halherta/GPIO_ADC_uHAT/production/bom.xls

Comment | Designator | Footprint | JLCPCB Part #
10k | R1,R5,R6 | 1206 | C17902
1k | R2 | 1206 | C1469
Conn_01x02 | J5 | PinHeader_1x02_P2.54mm_Vertical | C492401
CAT24C128 | U3 | SOIC-8_3.9x4.9mm_P1.27mm | C81195
3.9k | R3,R4 | 1206 | C17883
Conn_01x10 | J2,J3 | PinHeader_1x10_P2.54mm_Vertical | C5116489
Conn_01x08 | J4 | PinHeader_1x08_P2.54mm_Vertical | C5224027
MCP3208 | U4 | SOIC-16_3.9x9.9mm_P1.27mm | C16939
MCP23017_SO | U1 | SOIC-28W_7.5x17.9mm_P1.27mm | C47023
0.1u | C1,C2,C3 | 1206 | C1945
