halherta/GPIO_ADC_uHAT/schematic/GPIO_ADC_uHAT_schematic.pdf

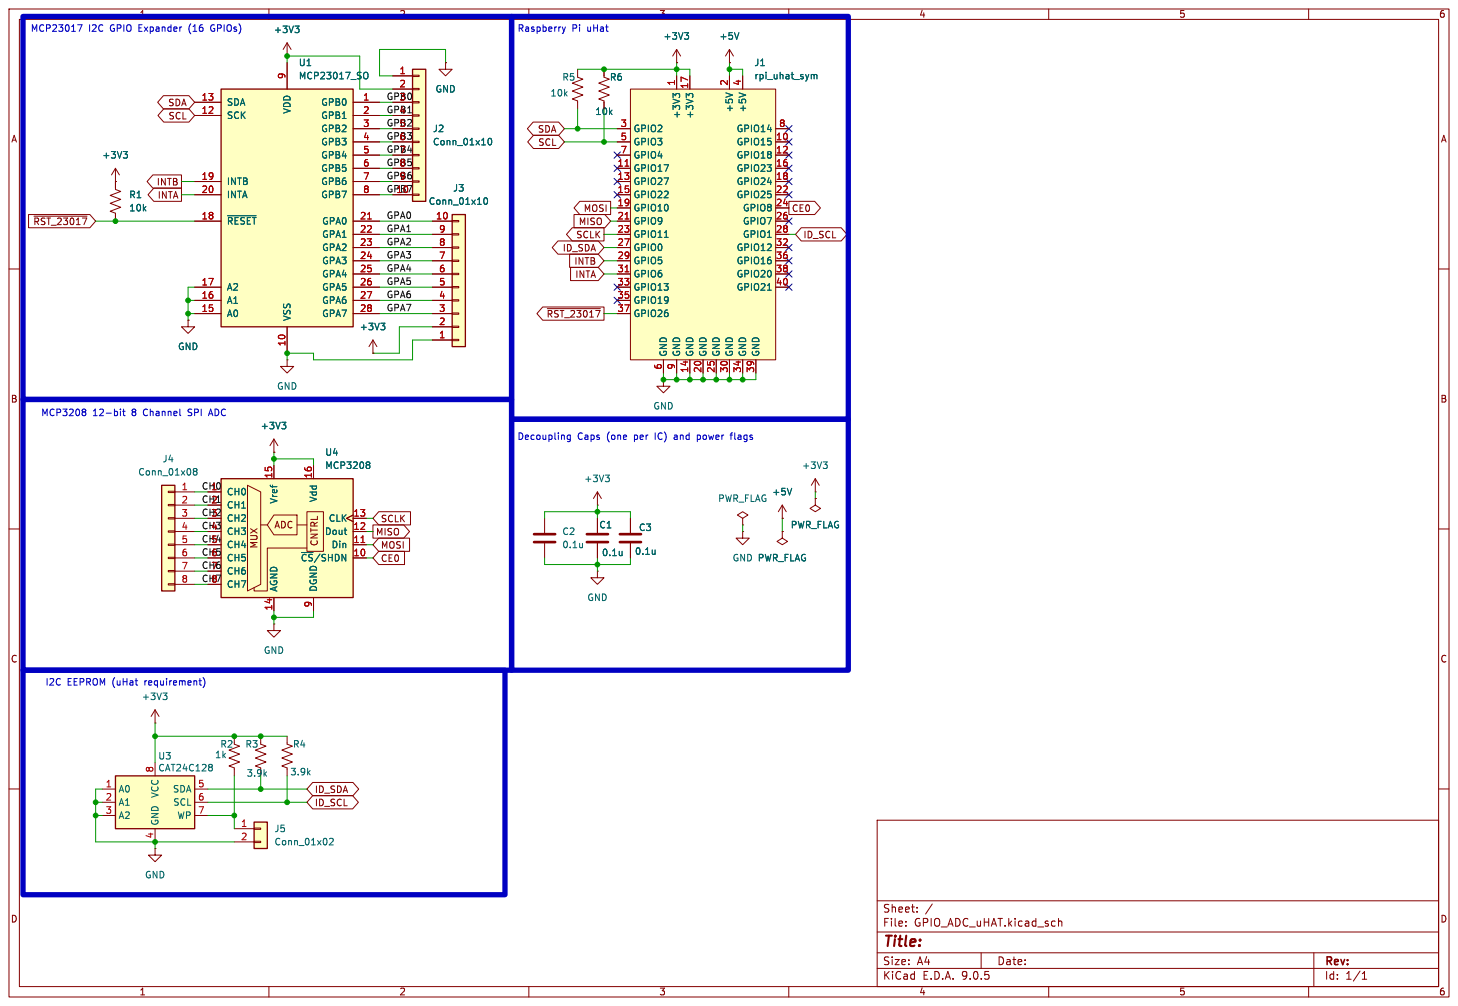
[picture p1: page 1]

Id: 1/1 Title: File: GPIO_ADC_uHAT.kicad_sch Sheet: /
