halherta/GPIO_ADC_uHAT/GPIO_ADC_uHAT.kicad_pcb

## KiCad design GPIO_ADC_uHAT.kicad_pcb (2025-11-06)

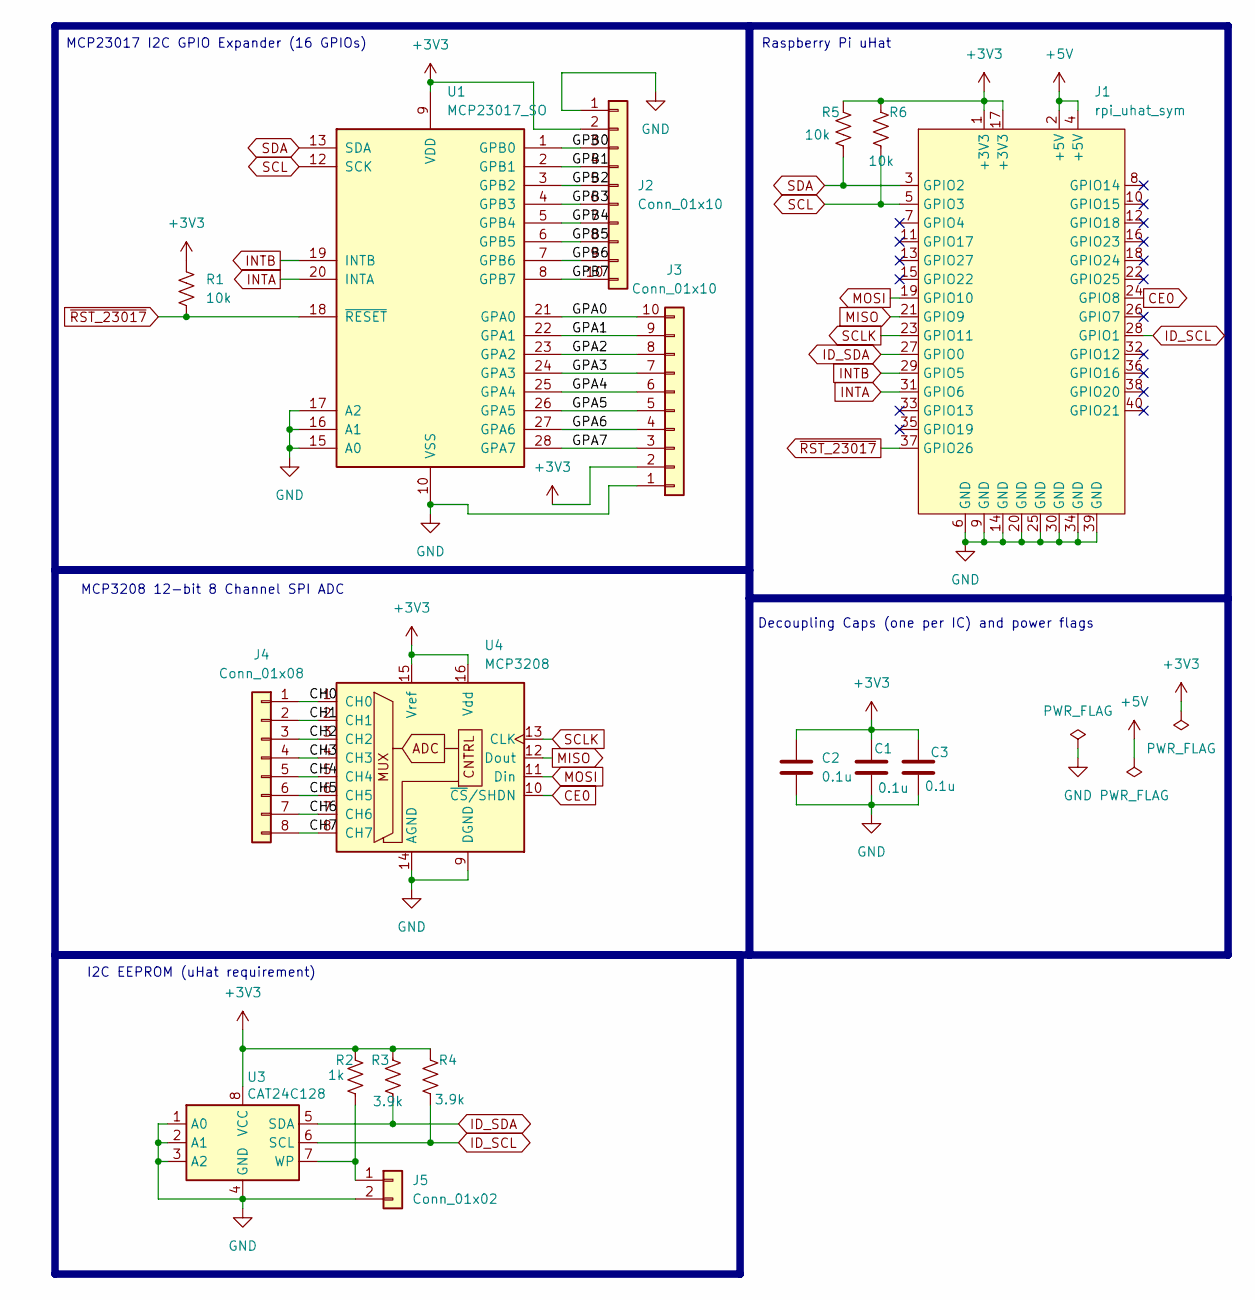
[picture p2: schematic GPIO_ADC_uHAT.kicad_sch]

Parts:
C1, C2, C3: 0.1u; C_1206_3216Metric_Pad1.33x1.80mm_HandSolder
J1: rpi_uhat_sym; rpi_uhat_fpt_v2
J2, J3: Conn_01x10; PinHeader_1x10_P2.54mm_Vertical
J4: Conn_01x08; PinHeader_1x08_P2.54mm_Vertical
J5: Conn_01x02; PinHeader_1x02_P2.54mm_Vertical
R1, R5, R6: 10k; R_1206_3216Metric_Pad1.30x1.75mm_HandSolder
R2: 1k; R_1206_3216Metric_Pad1.30x1.75mm_HandSolder
R3, R4: 3.9k; R_1206_3216Metric_Pad1.30x1.75mm_HandSolder
U1: MCP23017_SO; SOIC-28W_7.5x17.9mm_P1.27mm
U3: CAT24C128; SOIC-8_3.9x4.9mm_P1.27mm
U4: MCP3208; SOIC-16_3.9x9.9mm_P1.27mm

Connections:
+3V3: C1.1, C2.1, C3.1, J1.1 (+3V3), J1.17 (+3V3), J2.2, J3.2, R1.1, R2.1, R3.1, R4.1, R5.1, R6.1, U1.9 (VDD), U3.8 (VCC), U4.15 (Vref), U4.16 (Vdd)
+5V: J1.2 (+5V), J1.4 (+5V)
/CH0: J4.1, U4.1 (CH0)
/CH1: J4.2, U4.2 (CH1)
/CH2: J4.3, U4.3 (CH2)
/CH3: J4.4, U4.4 (CH3)
/CH4: J4.5, U4.5 (CH4)
/CH5: J4.6, U4.6 (CH5)
/CH6: J4.7, U4.7 (CH6)
/CH7: J4.8, U4.8 (CH7)
/GPA0: J3.10, U1.21 (GPA0)
/GPA1: J3.9, U1.22 (GPA1)
/GPA2: J3.8, U1.23 (GPA2)
/GPA3: J3.7, U1.24 (GPA3)
/GPA4: J3.6, U1.25 (GPA4)
/GPA5: J3.5, U1.26 (GPA5)
/GPA6: J3.4, U1.27 (GPA6)
/GPA7: J3.3, U1.28 (GPA7)
/GPB0: J2.3, U1.1 (GPB0)
/GPB1: J2.4, U1.2 (GPB1)
/GPB2: J2.5, U1.3 (GPB2)
/GPB3: J2.6, U1.4 (GPB3)
/GPB4: J2.7, U1.5 (GPB4)
/GPB5: J2.8, U1.6 (GPB5)
/GPB6: J2.9, U1.7 (GPB6)
/GPB7: J2.10, U1.8 (GPB7)
CE0: J1.24 (GPIO8), U4.10 (~CS/SHDN)
GND: C1.2, C2.2, C3.2, J1.6 (GND), J1.9 (GND), J1.14 (GND), J1.20 (GND), J1.25 (GND), J1.30 (GND), J1.34 (GND), J1.39 (GND), J2.1, J3.1, J5.2, U1.10 (VSS), U1.15 (A0), U1.16 (A1), U1.17 (A2), U3.1 (A0), U3.2 (A1), U3.3 (A2), U3.4 (GND), U4.9 (DGND), U4.14 (AGND)
ID_SCL: J1.28 (GPIO1), R4.2, U3.6 (SCL)
ID_SDA: J1.27 (GPIO0), R3.2, U3.5 (SDA)
INTA: J1.31 (GPIO6), U1.20 (INTA)
INTB: J1.29 (GPIO5), U1.19 (INTB)
MISO: J1.21 (GPIO9), U4.12 (Dout)
MOSI: J1.19 (GPIO10), U4.11 (Din)
unnamed: J5.1, R2.2, U3.7 (WP)
SCL: J1.5 (GPIO3), R6.2, U1.12 (SCK)
SCLK: J1.23 (GPIO11), U4.13 (CLK)
SDA: J1.3 (GPIO2), R5.2, U1.13 (SDA)
~RST_23017: J1.37 (GPIO26), R1.2, U1.18 (~RESET)

Notes on the sheet:
Decoupling Caps (one per IC) and power flags
MCP3208 12-bit 8 Channel SPI ADC
I2C EEPROM (uHat requirement)
Raspberry Pi uHat
MCP23017 I2C GPIO Expander (16 GPIOs)

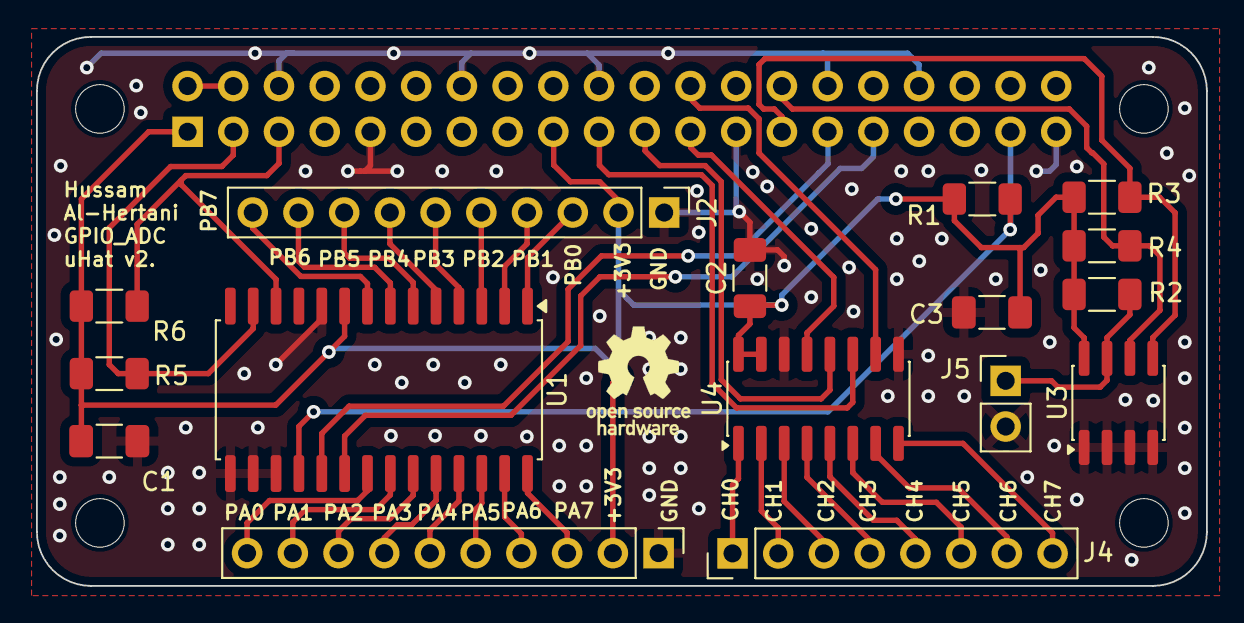
[picture p3: board GPIO_ADC_uHAT.kicad_pcb from above]

Board: 2 copper layers, 65.0 x 30.5 mm, 17 parts (0 on the bottom side), 39 nets.
