halherta/GPIO_ADC_uHAT/(commit log)

2025-11-06 made some modifications and added test code
    [GPIO_ADC_uHAT.kicad_pcb, GPIO_ADC_uHAT.kicad_sch]
2025-11-06 added pdf schematic
